Andi0802/LevelMeasurement/sdcard/TestP1.bmp

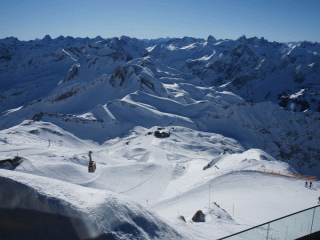
sdcard/TestP1.bmp
