Andi0802/LevelMeasurement/doc/Geraet_02/20190227_194509.jpg

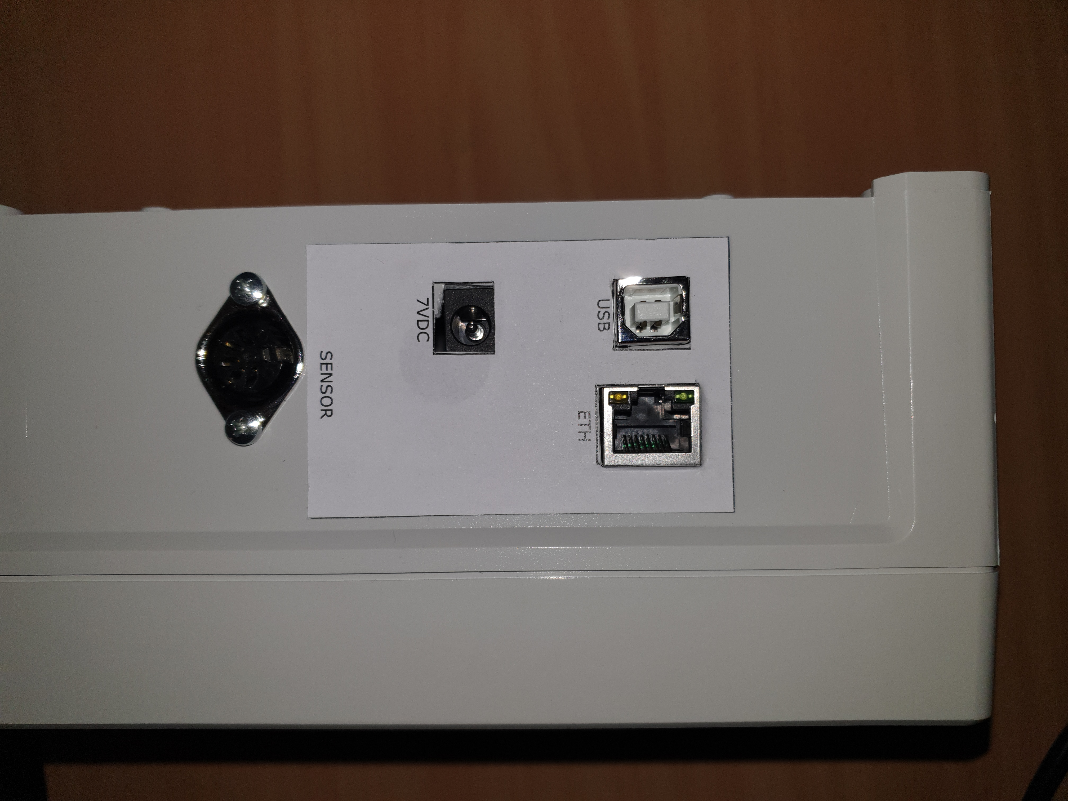
doc/Geraet_02/20190227_194509.jpg
