Andi0802/LevelMeasurement/doc/Geraet_01/Arduino_inside.jpg

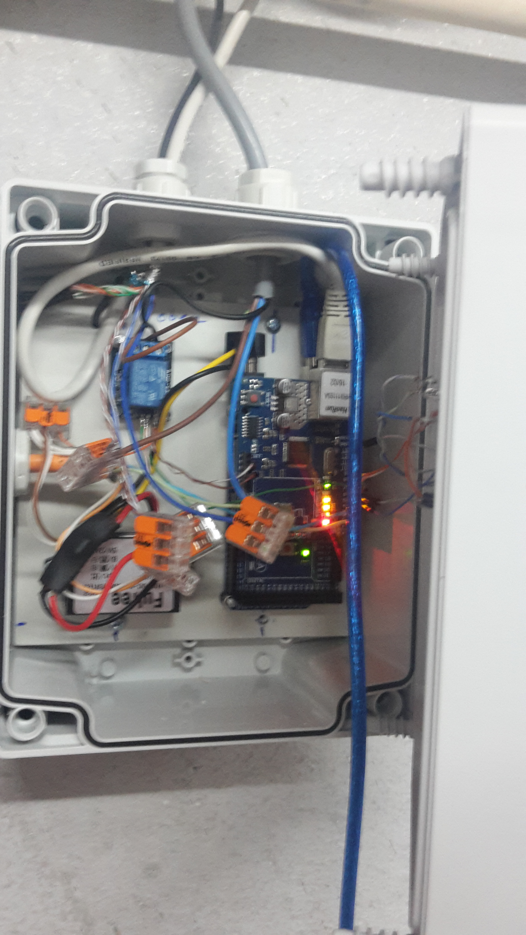
doc/Geraet_01/Arduino_inside.jpg
