Andi0802/LevelMeasurement/doc/Geraet_01/Sensor_1.jpg

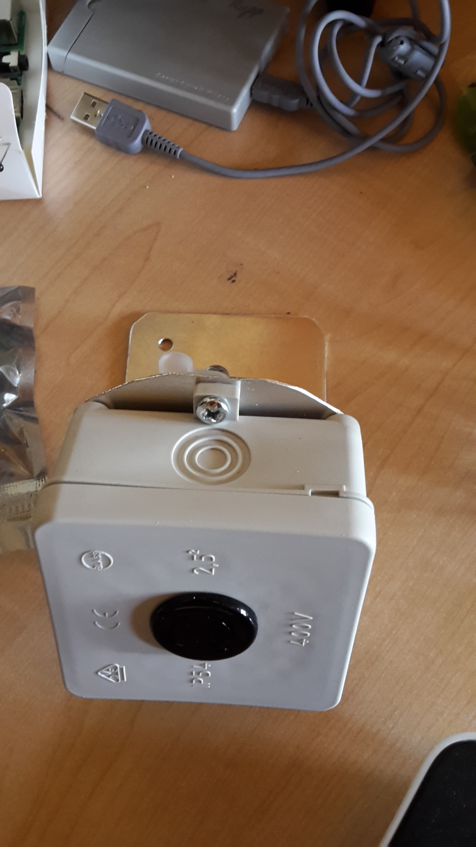
doc/Geraet_01/Sensor_1.jpg
