Andi0802/LevelMeasurement/doc/Geraet_01/Sensor_2.jpg

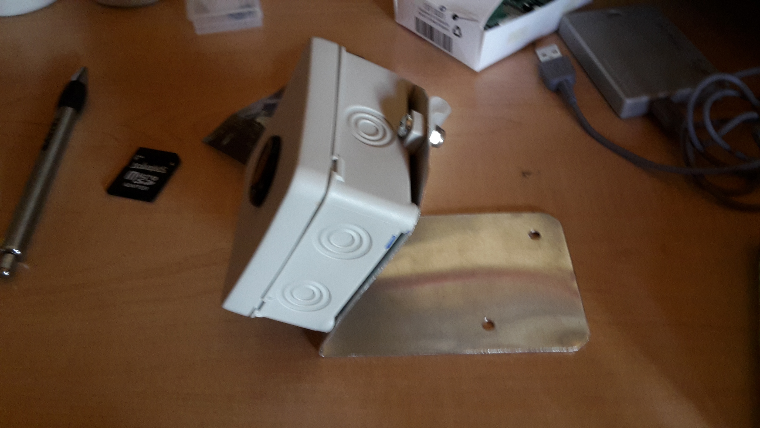
doc/Geraet_01/Sensor_2.jpg
