Andi0802/LevelMeasurement/doc/Geraet_02/20190227_194631.jpg

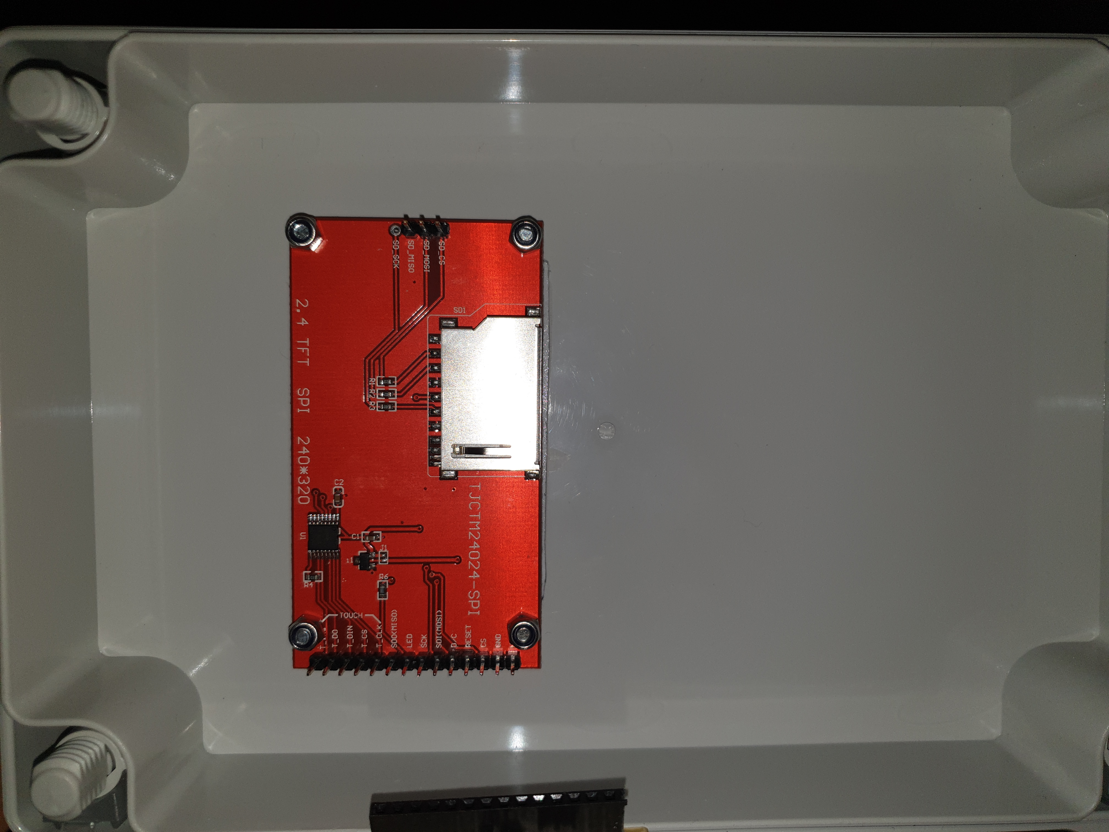
doc/Geraet_02/20190227_194631.jpg
