Andi0802/LevelMeasurement/doc/Geraet_02/20190227_195342.jpg

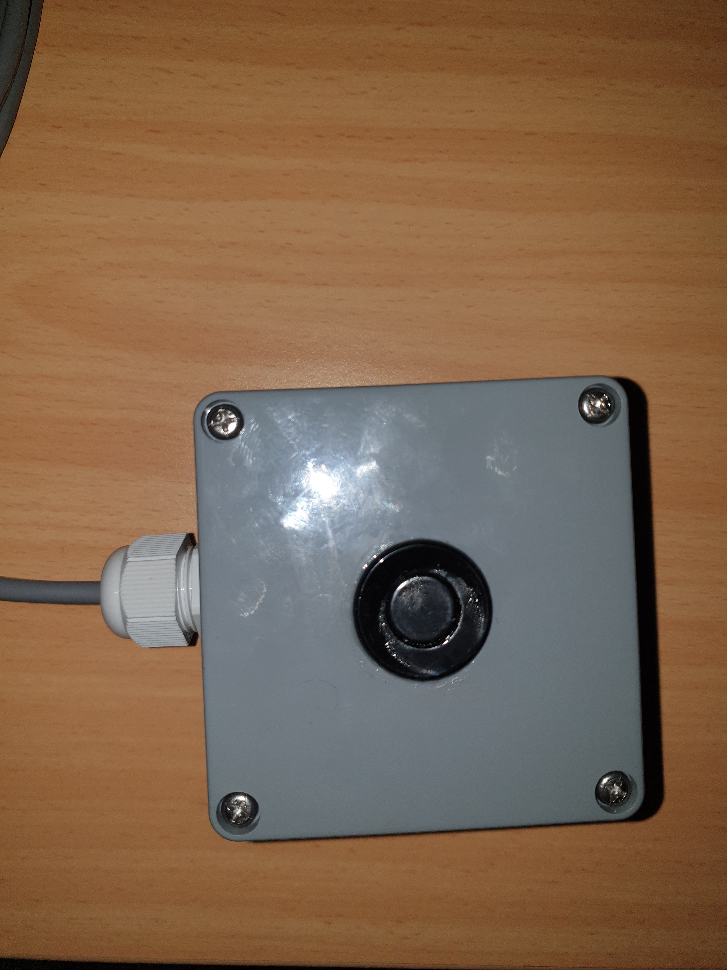
doc/Geraet_02/20190227_195342.jpg
