Andi0802/LevelMeasurement/doc/Geraet_02/20190227_195350.jpg

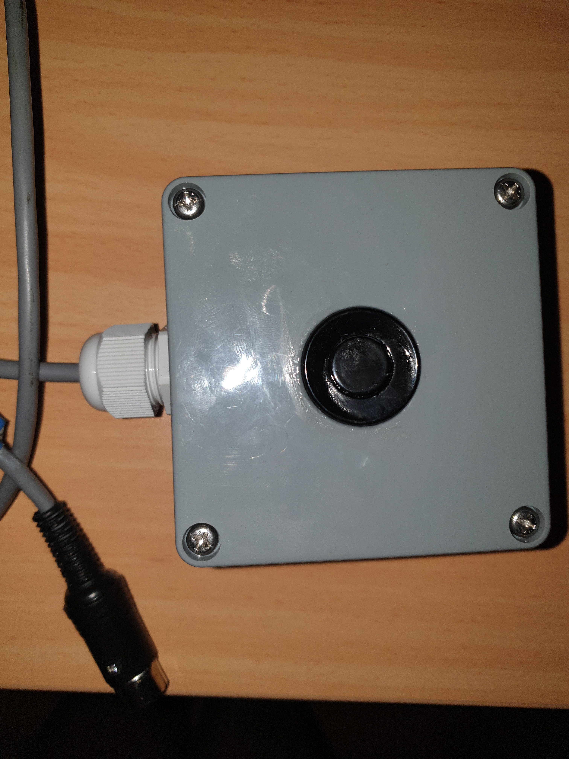
doc/Geraet_02/20190227_195350.jpg
