Andi0802/LevelMeasurement/doc/Hardware.xlsx

Sheet: Verkabelung
Arduino | Signal | Ziel | X1 |  |  |  | Abkürzungen
2 | TRIG | US/gn | 5 |  |  |  | US | Ultraschallsensor incl Auswertung
3 | ECHO | US/bl | 4 |  |  |  | BUT | Taster mit LED
GND | US-GND | US/br,ws-br | 3 |  |  |  | REL | Relais
5V | US-5V | US/or-ws | 1 |  |  |  | SYSLED | System LED
6 | BUTTON | BUT/gn |  |  |  |  | POE+ | PoE V+ Versorgung max. 12-48V
GND | BUTTON-GND | BUT/bl-ws |  |  |  |  | POE- | PoE V- Versorgung max. 12-48V
5 | BUTTON-LED | BUT/bl
7 | RELAIS | REL/gn |  |  |  |  | Stecker
GND | RELAIS-GND | REL/ws-br |  |  |  |  | X1 | 5poliger Hirschmann f
5V | RELAIS-5V | REL/br |  |  |  |  | X2 | 26 poliges Flachbandkabel
8 | SYSLED+ | SYSLED/or-ws
9 | SYSLED- | SYSLED/or
 | POE+
 | POE- | bl/bl-ws
4 | /CS SDCARD | ETH Shield | direkt
13 | SCK ETH+SD | ETH Shield | direkt
12 | MISO ETH+SD | ETH Shield | direkt
11 | MOSI ETH+SD | ETH Shield | direkt
10 | /CS ETH | ETH Shield | direkt
 |  |  | X2 | 74LVC245 in | 74LVC245 out | ILI9341 Name | ILI9341 Pin
37 | LED Display | ILI9341 | 8 | 47R |  | LED | 8
52 | SCK Display | ILI9341 | 7 | 3 | 17 | SCK, T_CLK | 7.1
40 | CD Display | ILI9341 | 5 | 5 | 15 | C/D | 5
51 | MOSI Display | ILI9341 | 6 | 4 | 16 | SDI, T_DI | 6.12
50 | MISO Display | ILI9341 | 9 |  |  | SDO, T_DO | 9.13
39 | /CS Display | ILI9341 | 3 | 7 | 13 | /CS | 3
36 | /RESET Display | ILI9341 | 4 | 6 | 14 | RESET | 4
20 | TRIG Touch | ILI9341 | 11 |  |  | T_IRQ | 14
34 | /CS Touch | ILI9341 | 10 | 2 | 18 | T_CS | 11
 | 5V | ILI9341 | 1 |  |  | VCC | 1
 | GND | ILI9341 | 2 | 10.19 | GND, /OE | GND | 2
 | 3V3 | ILI9341 | 12 | 1.2 | DIR, 3V3

Sheet: Stückliste
Pos | Anzahl | Artikel
1 | 1 | Arduino Mega 2560 compatible
2 | 1 | ETH Shield für Mega 2560
3 | 1 | Relaiplatine 230VAC
4 | 1 | US Sensor mit Auswerteelektronik
5 | 1 | Display 2,4" 320x240 ILI9341 Touch, Seriell
