Andi0802/LevelMeasurement/doc/Kalibrierung.xlsx

US-Entfernungsmessung Offset und Schallgeschwindigkeitsbestimmung
 |  | v Schall [mm/s] |  | v Schall [mm/s] | hOffset [mm]
 |  | 34320 |  | 34708.73786 | -25.11
Messung [-] | Laser [mm] | US Sensor [mm] | Delta [mm] | US Sensor [mm] | Delta Korr [mm]
1 | 891 | 857.14 | 33.86 | 891.9587055 | -0.9587055016
2 | 890 | 852.16 | 37.84 | 886.9222977 | 3.077702265
3 | 891 | 853.66 | 37.34 | 888.439288 | 2.560711974
4 | 583 | 549.6 | 33.4 | 580.9352427 | 2.064757282
5 | 583 | 549.64 | 33.36 | 580.9756958 | 2.024304207
6 | 583 | 549.66 | 33.34 | 580.9959223 | 2.00407767
7 | 1434 | 1399.12 | 34.88 | 1440.077638 | -6.07763754
8 | 1435 | 1388 | 47 | 1428.831683 | 6.168317152
9 | 1435 | 1388 | 47 | 1428.831683 | 6.168317152
10 | 2397 | 2341.66 | 55.34 | 2393.293657 | 3.706343042
11 | 2396 | 2341.78 | 54.22 | 2393.415016 | 2.584983819
12 | 2398 | 2341.84 | 56.16 | 2393.475696 | 4.524304207
13 | 1873 | 1829 | 44 | 1874.826828 | -1.826828479
14 | 1872 | 1829.34 | 42.66 | 1875.17068 | -3.170679612
15 | 1873 | 1828.66 | 44.34 | 1874.482977 | -1.482977346
