Andi0802/LevelMeasurement/(threads)

Thread 2 (2018-09-22):

Add minimum rain quantity for filter diagnosis to parameter list

Andi0802, 2018-09-22:
Currently minimum rain quantity required for filter diagnosis is a define (MIN_VOL_RAIN).
It would be helpful if it becomes a setting to be set via WebServer and stored in EEPROM

Andi0802, 2018-10-07:
solved in V3.0.1 but spelling error to be corrected

Andi0802, 2018-10-07:
solved in V3.0.1

Closed 2018-10-07.

Thread 3 (2018-09-22):

Catch sproradic ethernet stalls

Andi0802, 2018-09-22:
Sporadically Ethernet is stalling. Suspicion is a simulanous LOW state of CS signals from ETH and SD-Card.
No stalls since a workaround was implemented in WriteSystemLog Function.
In other functions with SD Card access no workaround is implemented.
Catch CS signals if they are simulanously in LOW state and write to System Logfile

Andi0802, 2018-10-07:
Code to catch issue added for testing

Closed 2018-10-07.

Thread 5 (2018-09-22):

Optimize EEPROM Access

Andi0802, 2018-09-22:
EEPROM is written with write. This writes the complete EEPROM in any case even if value is the same.
Use put instead

Andi0802, 2018-10-07:
solved in V3.0.1

Closed 2018-10-07.

Thread 7 (2018-09-24):

Filter diagnose issue

Andi0802, 2018-09-24:
Rain quantitative is no used currently. Use Maximum out of 10days.During das with strohg rain Filter wffociency is lower than for das with lese rain. So effciency is dependent on rain quantity. Check strong rain eventuell from 23.9.
Data: 17.7l/24h 897l/24h Level change.
Around 62% Efficiency

Andi0802, 2018-10-07:
Filter diagnosis based on 24h is not accurate enough. Redesign on hourly basis required

Andi0802, 2018-10-23:
Implemented without test

Closed 2018-10-23.

Thread 14 (2018-10-28):

Wrong indication in Web-server

Andi0802, 2018-10-28:
1h rain, 24h rain in Web-Server section "DIagnosis" is not correct.
Here actual value is shown and not value used for last diagnosis.
24h rain is not necessary under section "Diagnosis" --> remove
1h Rain actual value should be displayed under "Measurement" section.
Filter diagnosis deviation to be limited to 0%, if more water is in reservoir than calculated by model.
For diagnosis 24h usage value (mean) is used. This is wrong. Use fixed value in 1h: 20 Liter.

Andi0802, 2018-10-28:
Solved in V3.0.6, test started

Closed 2018-10-28.

Thread 21 (2018-11-11):

Correct header and web-indication

Andi0802, 2018-11-11:
Header in datalog file is incorrect (usage 24h/filter diag 1h)
Last date is not indicated in web-interface
24h value of refilling is indicated in filter diag instead of 1h value

Thread 22 (2018-11-11):

1h-values not correct in case of variant measurement time

Andi0802, 2018-11-11:
If distance between measurements in not exactly 1h "1h" values are incorrect

Andi0802, 2018-11-11:
Latest measurement time is stored, Rain quantity is taken only if difference between last two measurement is more than 50min. No conversion from actual time distance btw. 2 measurements and 1h is done to avoid extrapolation issues!!! So 1h-Interval means >50min.
Results of faster measurements (after refill or in case of errors) are skipped for diagnosis

Closed 2018-11-11.
