Andi0802/LevelMeasurement/(commit log)

2018-09-22 First stable version rebased from old project Zisterne
    [180819_V10_1.csv, 180819_V10_2.csv, 180819_V20_1.csv, 180819_V20_2.csv, 180819_V21_1.csv, 180820_V21_2.csv, 180820_V21_3.csv, 180820_V22_1.csv]
2018-09-22 EEPROM Access with put (#5), Testcode to catch ethernet stalls (#3), Minimum rain quantity as parameter (#2)
    [Requirements.xlsx]
2018-10-18 interim solution for test
    [Datensammlung.xlsm]
2018-10-21 Datalog file issue solved (#9), Unit of sound velocity changed
    [LevelMeasurement.ino]
2018-10-22 LogFile column error corrected
    [181022_V3011_1.csv, Datensammlung.xlsm]
2018-10-22 Bugfix measurement timing (#11)
    [181022_V303_1.csv, Datensammlung.xlsm]
2018-10-23 1h Rain quantity in web-interface (#13)
    [181023_V303_1.csv, Datensammlung.xlsm]
2018-10-23 Store history values in EEP (#6), improvement filter diagnosis
2018-10-24 Correction names filter diagnosis and usage
    [LevelMeasurement.ino]
2018-10-28 Diagnosis display in web-server (#14).
    [181028_V305_1.csv, Datensammlung.xlsm]
2018-10-31 Test code for NaN problem
    [LevelMeasurement.ino]
2018-11-02 avr controller watchdog used instead of counter; NewEEPROM Lib and NetEEPROM Lib used instead of classic EEPROM lib; Corrections LOGLVL_WEB; Reset and Reprogram option in Web server
    [181102_V307_1.csv, Datensammlung.xlsm]
2018-11-07 NaN received as actual rain (#15) Moving average calculation wrong (#16) Timeout handling missing if no answer at all (#18) Homematic access switchable (#19) Reset possibility over web; use real AVR 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
    [181104_V307_2.csv, 181105_V307_3.csv, 181107_V307_4.csv, Datensammlung.xlsm]
2018-11-11 Correct header and web-indication #21 Split into multiple files for better maintanance #23 Add ILI9341 display #24
    [181111_V310_1.csv, Datensammlung.xlsm]
2018-11-11 1h-values not correct in case of variant measurement time #22
    [LevelMeasurement.ino]
2018-11-14 Create SVG File with diagram, history values in EEP
    [Datensammlung.xlsm]
2018-12-09 Auswertefile Python, Doku, Logfiles umsortiert
    [180819_V10_1.csv, 180819_V10_2.csv, 180819_V20_1.csv, 180819_V20_2.csv, 180819_V21_1.csv, 180820_V21_2.csv, 180820_V21_3.csv, 180820_V22_1.csv]
2018-12-12 Python Auswertescript mit automatischem Auslesen der Website
    [181209165900_V310.csv, 181209193100_V310.csv, 181212175600_V310.csv, 181212185337_V310.csv, Datensammlung.csv]
2018-12-15 old excel file moved to bak folder
    [Datensammlung.xlsm]
2018-12-22 Testcode entfernt EEPROM Fehler behoben (Testcode)
    [EEP_functions.ino, LevelMeasurement.ino]
2018-12-23 Small corrections svg File, WDT Retrigger in Webserver, Diagnosis off beow 90% max
    [LevelMeasurement.ino, Web_Server.ino]
2019-02-02 Display ILI9341 added. Coordination CS-Signals SPI in startup
2019-02-02 TimeLib updated, Correction EEP and 24h change
    [EEP_functions.ino, LevelMeasurement.ino]
2019-02-24 History display in Web Server, Correction unit in webserver, Correction volDiff24h for usage calculation
    [LevelMeasurement.ino, Web_Server.ino, display.ino]
2019-05-11 typo in hm_ccu variable corrected
    [LevelMeasurement.ino]
2019-05-11 HM Access HTTP request corrected
    [hm_access.ino]
2019-11-28 Logging detailled in case of inplausible response
    [data_collection.csv, data_collection.xlsx, data_collection_raw.xlsx]
2021-01-24 data collection stored, .gitignore
    [data_collection.xlsx, data_collection_raw.xlsx]
2021-03-07 SQL added, Simulation mode added
    [data_collection.csv, data_collection.xlsx, data_collection_raw.xlsx]
2021-03-13 Data saved and copied into SQL-Table, Config: SQL activated
    [data_collection.xlsx, data_collection_raw.xlsx, daten_import.csv, daten_import.xlsx]
2024-01-28 Limit prcActual to 100% Bugfix: LED was permanent off, when level 100% Makescript to new python version path
    [LevelMeasurement.ino]
