Andi0802/LevelMeasurement/doc/Geraet_02/20190227_194501.jpg

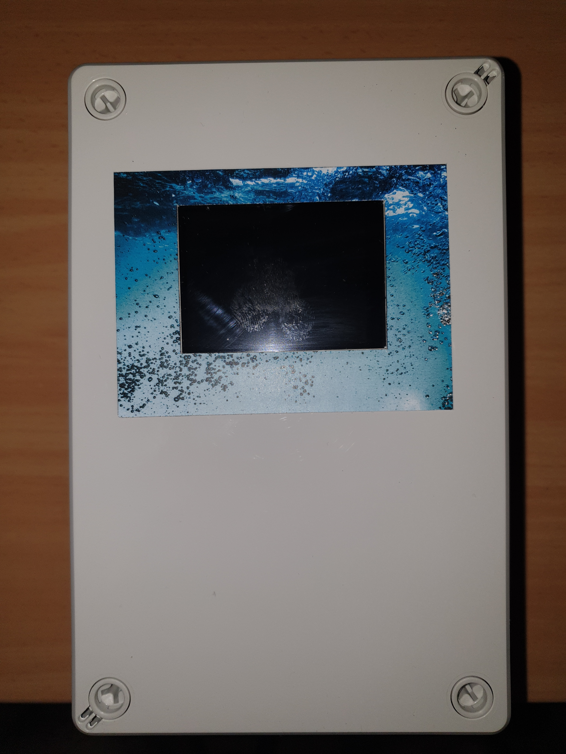
doc/Geraet_02/20190227_194501.jpg
